rosco-m68k/rosco_keyboard/pics/first-case-proto/IMG_1450.jpg

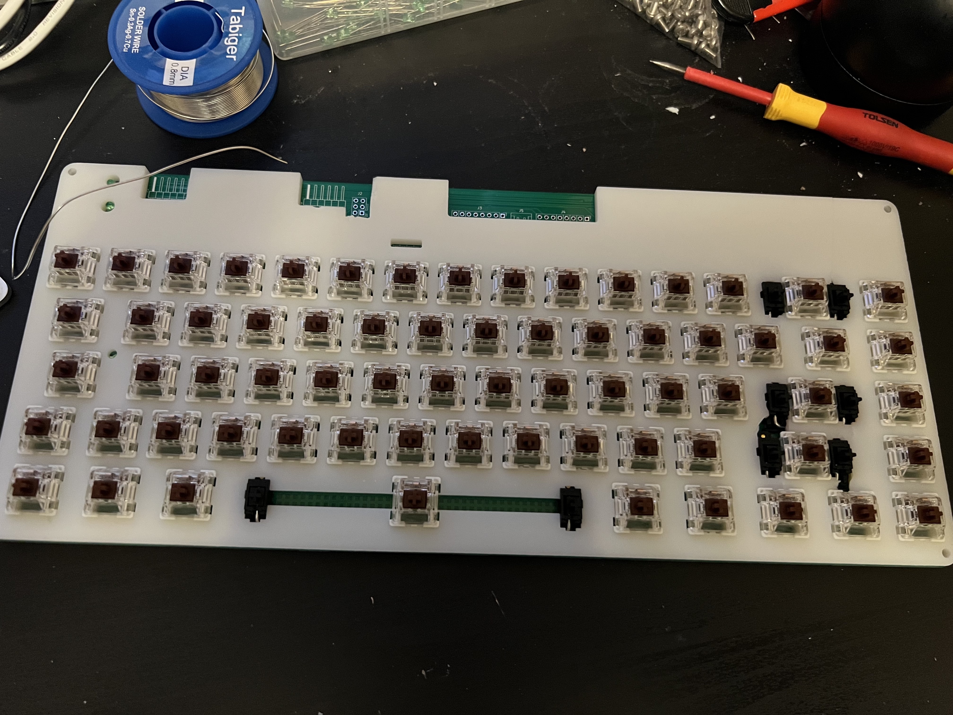
pics/first-case-proto/IMG_1450.jpg
