rosco-m68k/rosco_keyboard/README.md

## rosco_m68k keyboard / case concept

Made non-proprietary and released to open-source with the
licenses outlined in LICENSE.md and LICENSE.hardware, 
under my authority on April 23rd 2025.

_Ross Bamford_

_Managing Director_

_The Really Old-School Company Limited_
