rosco-m68k/rosco_keyboard/keyboard-2-plate v6.png

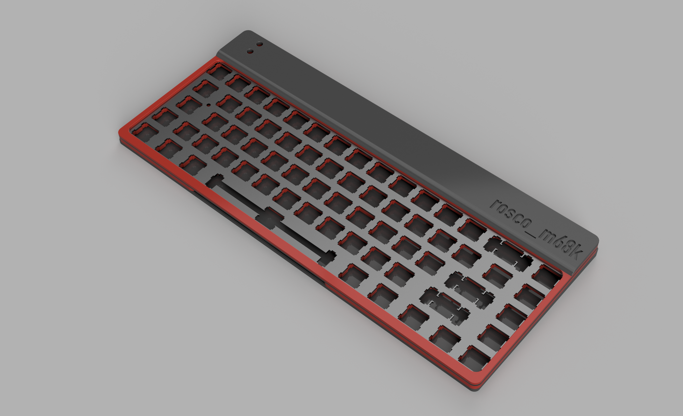
keyboard-2-plate v6.png
