rosco-m68k/rosco_keyboard/pics/first-case-proto/IMG_1453.jpg

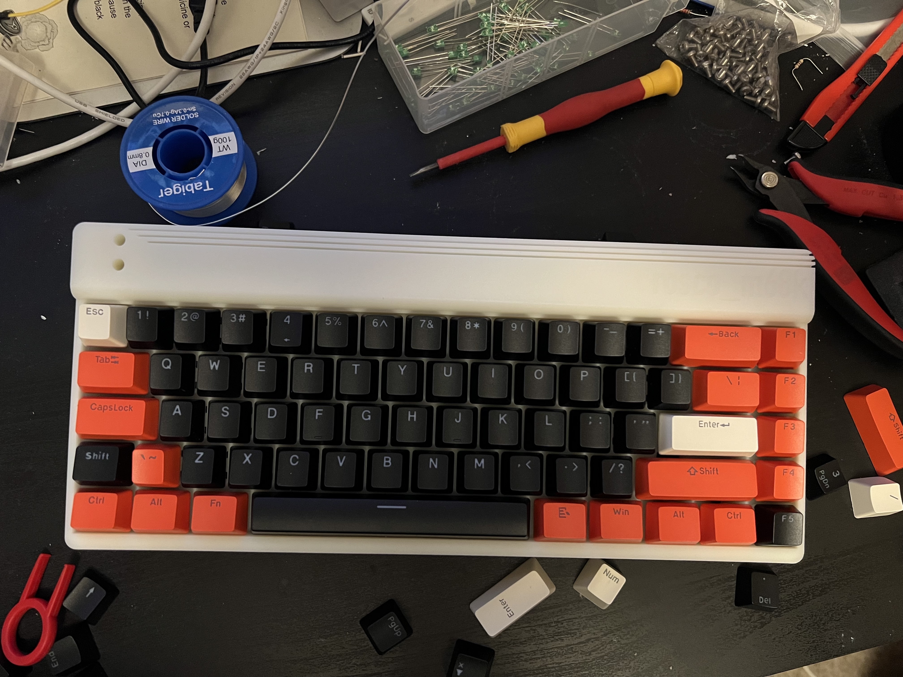
pics/first-case-proto/IMG_1453.jpg
