rosco-m68k/rosco_keyboard/rosco_m68k.png

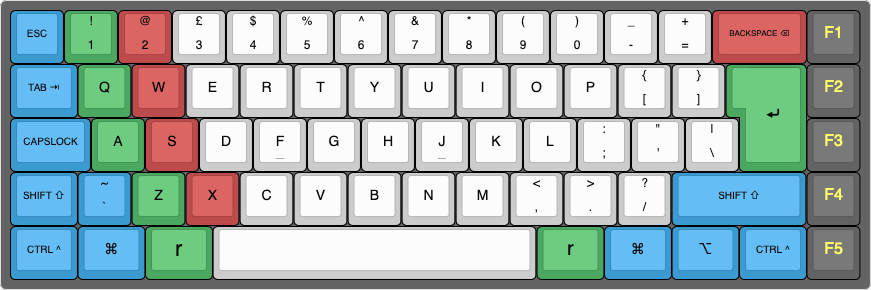
rosco_m68k.png
