rosco-m68k/rosco_keyboard/rosco_m68k_2.png

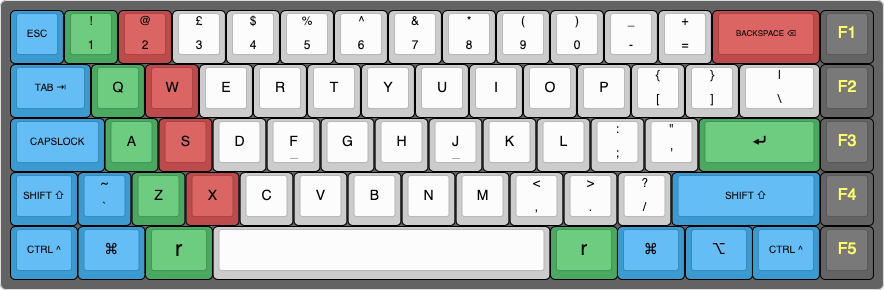
rosco_m68k_2.png
