rosco-m68k/rosco_keyboard/sample-renders/rosco_m68k_mini_case v2 back.png

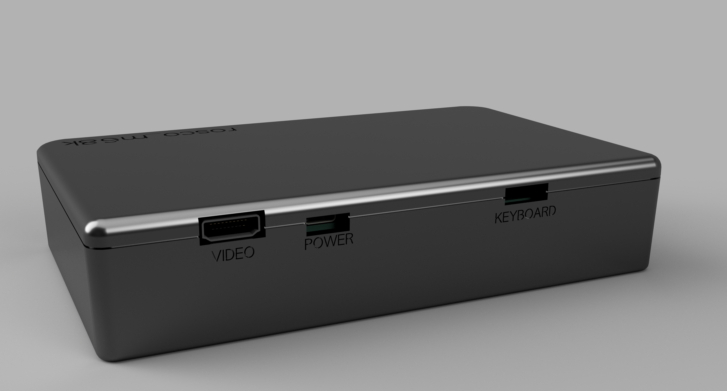
sample-renders/rosco_m68k_mini_case v2 back.png
