rosco-m68k/rosco_keyboard/3d_files/rosco_m68k_keyboard_v24_Base.step

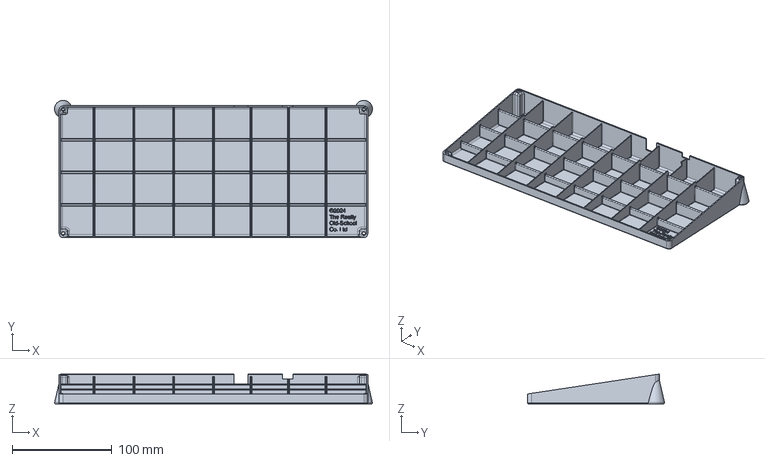
[picture p9: CAD file, 2024-02-29]
3d_files/rosco_m68k_keyboard_v24_Base.step
319.5 x 137.9 x 30.0 mm
