rosco-m68k/rosco_keyboard/3d_files/v27/keyboard-v27-pcb-placeholder.step

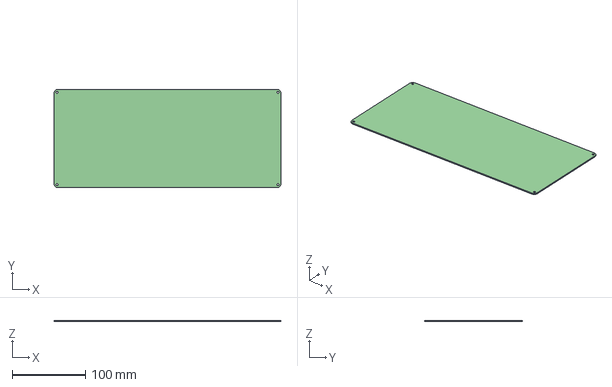
[picture p10: CAD file, 2025-04-23]
3d_files/v27/keyboard-v27-pcb-placeholder.step
310.1 x 134.0 x 1.60 mm
