rosco-m68k/rosco_keyboard/Board Models/rosco_m68k-r2020.STEP

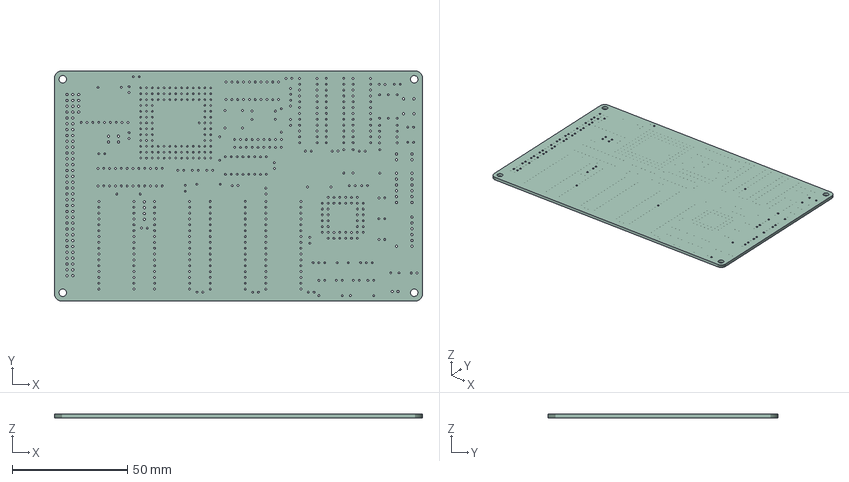
[picture p11: CAD file, 2024-03-07]
Board Models/rosco_m68k-r2020.STEP
160.0 x 100.0 x 1.60 mm
