rosco-m68k/rosco_keyboard/keys-illustration.stl

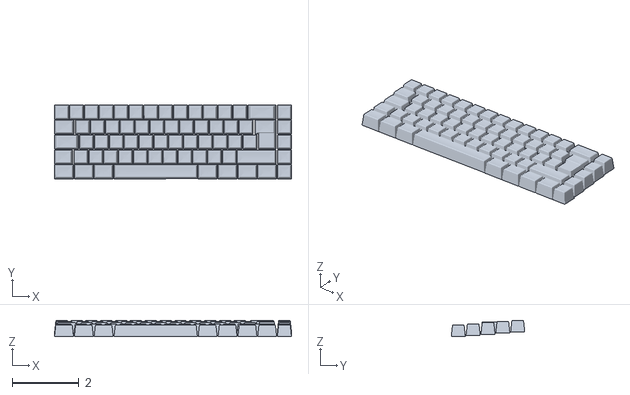
[picture p12: CAD file, 2024-03-07]
keys-illustration.stl
7.13 x 2.21 x 0.487
