rosco-m68k/rosco_keyboard/New Keyb Tests/keyboard-2-plate v25 - Support Holder.step

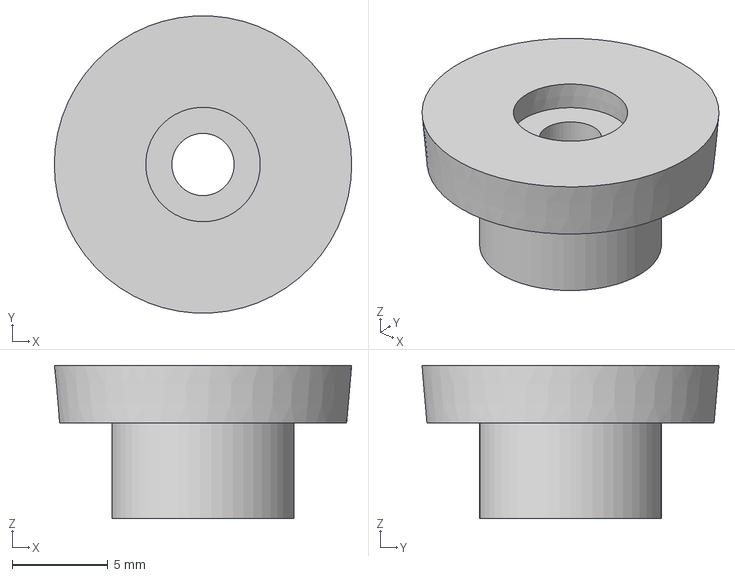
[picture p13: CAD file, 2025-04-23]
New Keyb Tests/keyboard-2-plate v25 - Support Holder.step
15.5 x 15.5 x 8.00 mm
