rosco-m68k/rosco_keyboard/standoffs/Side Standoff.step

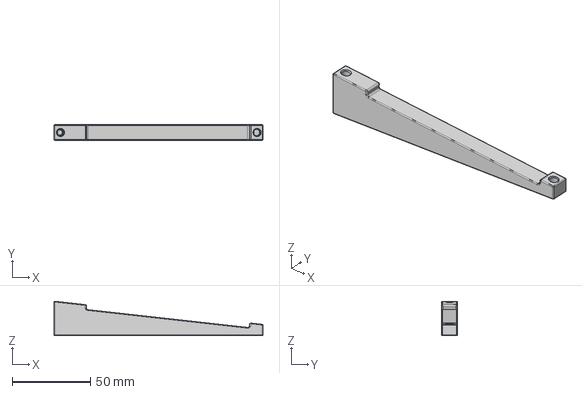
[picture p14: CAD file, 2024-02-17]
standoffs/Side Standoff.step
133.2 x 10.0 x 21.9 mm
