rosco-m68k/rosco_keyboard/3d_files/rosco_m68k_keyboard_v24_Top.step

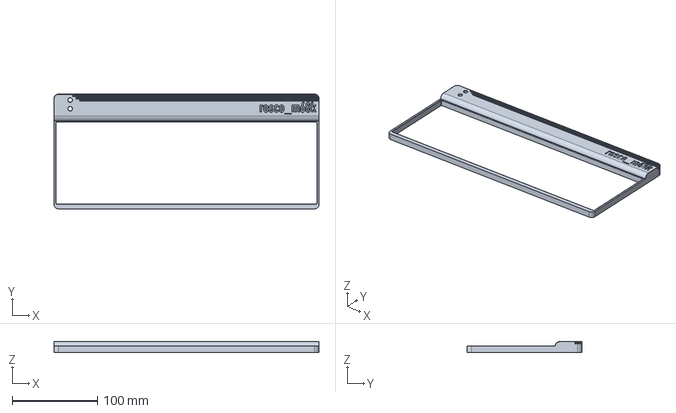
[picture p15: CAD file, 2024-02-29]
3d_files/rosco_m68k_keyboard_v24_Top.step
310.0 x 134.2 x 13.0 mm
