rosco-m68k/rosco_keyboard/New Keyb Tests/keyboard-2-plate v25 - Base LHS.step

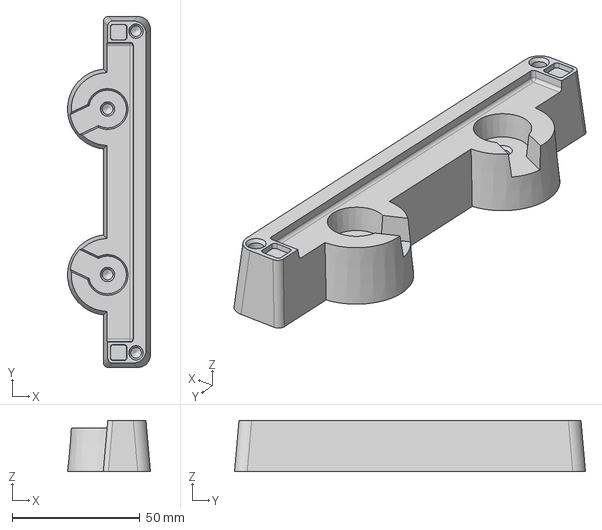
[picture p16: CAD file, 2025-04-23]
New Keyb Tests/keyboard-2-plate v25 - Base LHS.step
32.5 x 137.5 x 20.0 mm
