rosco-m68k/rosco_keyboard/New Keyb Tests/WIP/keyboard-2-plate RHS v2.step

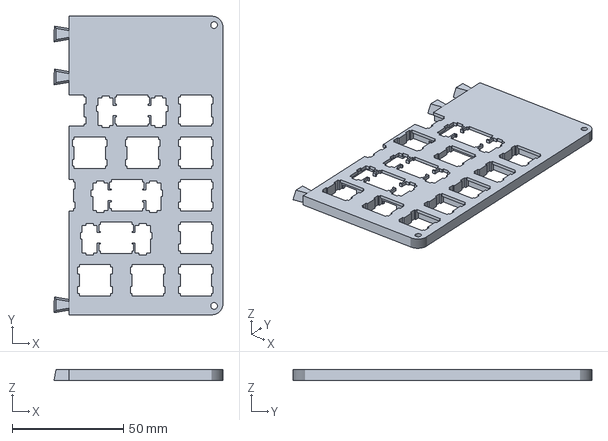
[picture p17: CAD file, 2025-04-23]
New Keyb Tests/WIP/keyboard-2-plate RHS v2.step
75.8 x 134.0 x 5.00 mm
