rosco-m68k/rosco_keyboard/rosco-keyboard-plate-new.dxf

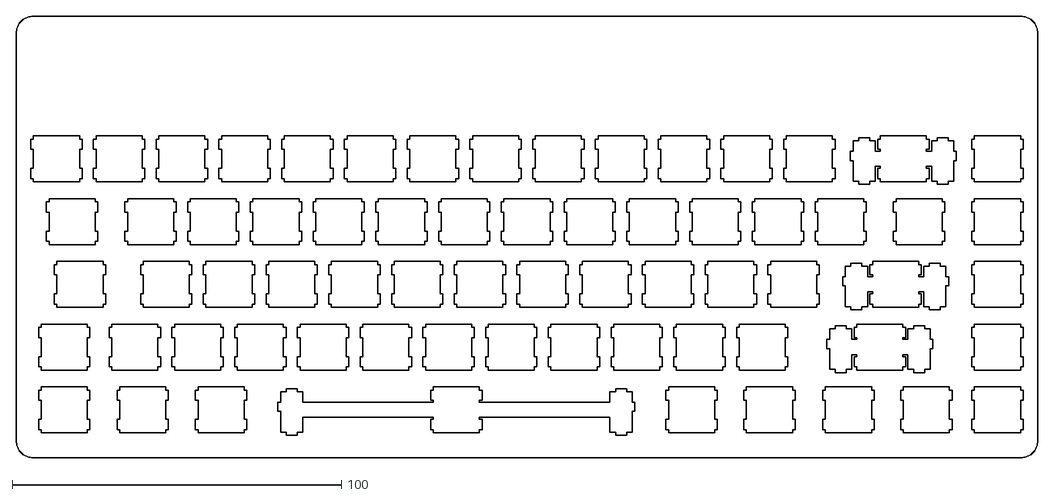
[picture p18: CAD file, 2023-12-27]
rosco-keyboard-plate-new.dxf
310.1 x 134.0
