rosco-m68k/rosco_keyboard/standoffs/keyboard-standoff v9.stl

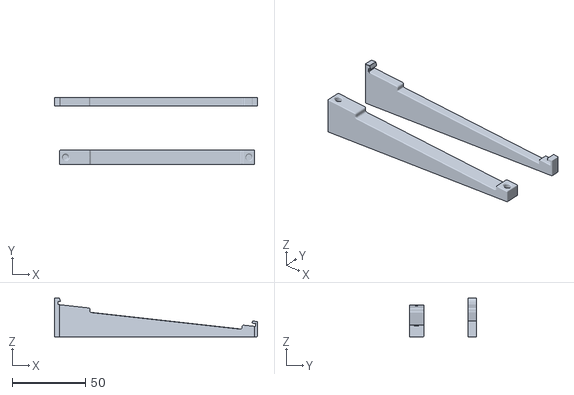
[picture p19: CAD file, 2024-02-17]
standoffs/keyboard-standoff v9.stl
138.6 x 46.0 x 26.5
