rosco-m68k/rosco_keyboard/New Keyb Tests/keyboard-2-plate v24 - Base Middle.step

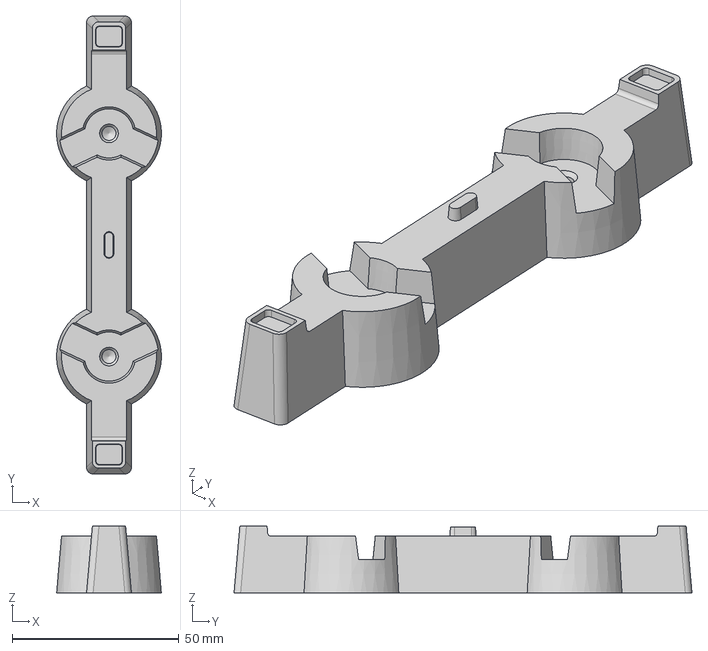
[picture p20: CAD file, 2025-04-23]
New Keyb Tests/keyboard-2-plate v24 - Base Middle.step
31.4 x 137.5 x 20.0 mm
