rosco-m68k/rosco_keyboard/recess-logo-test.stl

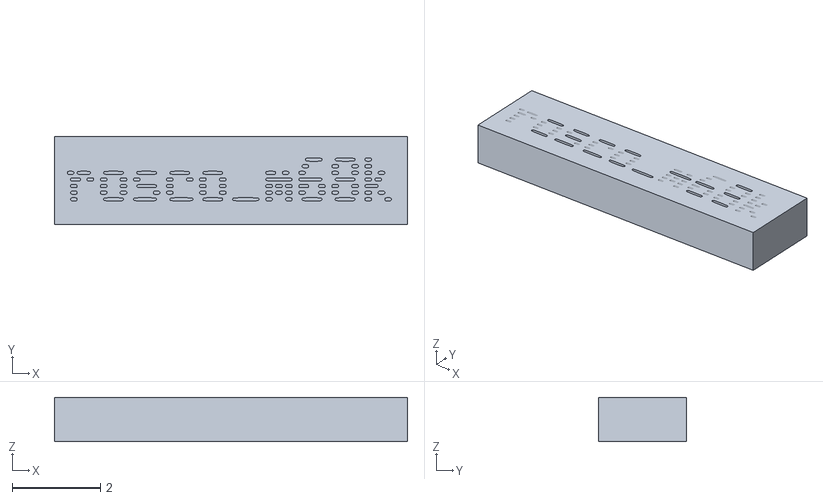
[picture p21: CAD file, 2023-12-16]
recess-logo-test.stl
8.00 x 2.00 x 1.00
