rosco-m68k/rosco_keyboard/New Keyb Tests/keyboard-2-plate v24 - Support X.step

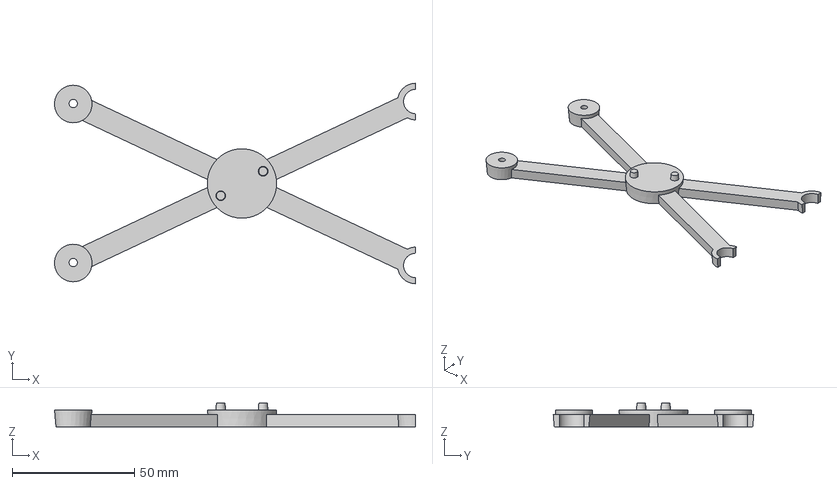
[picture p22: CAD file, 2025-04-23]
New Keyb Tests/keyboard-2-plate v24 - Support X.step
147.6 x 82.0 x 9.75 mm
