rosco-m68k/rosco_keyboard/New Keyb Tests/WIP/keyboard-2-plate v13 - Support Fix.step

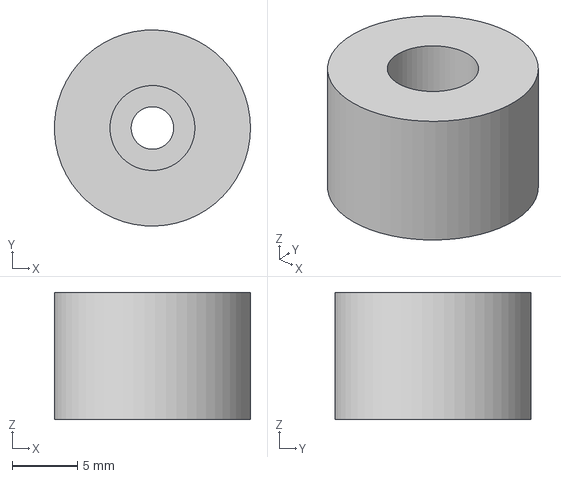
[picture p23: CAD file, 2025-04-23]
New Keyb Tests/WIP/keyboard-2-plate v13 - Support Fix.step
15.0 x 15.0 x 9.75 mm
