rosco-m68k/rosco_keyboard/standoffs/Middle Standoff.step

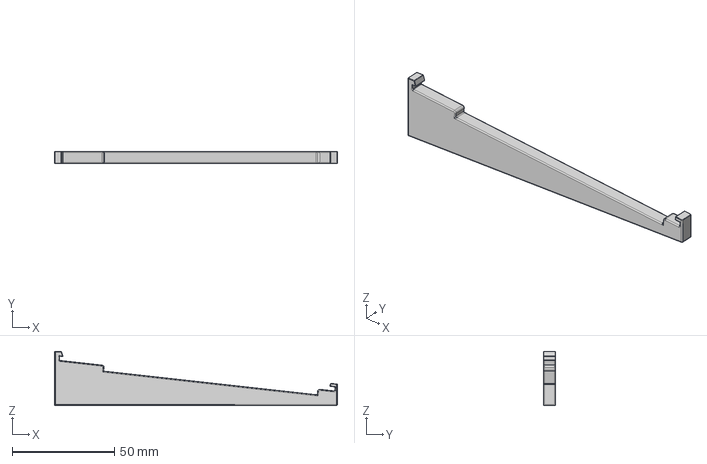
[picture p24: CAD file, 2024-02-15]
standoffs/Middle Standoff.step
138.6 x 6.00 x 26.5 mm
