rosco-m68k/rosco_keyboard/New Keyb Tests/WIP/keyboard-2-plate LHS v1.step

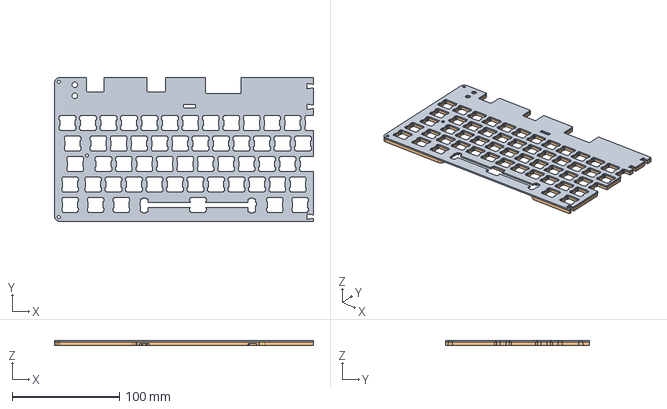
[picture p25: CAD file, 2025-04-23]
New Keyb Tests/WIP/keyboard-2-plate LHS v1.step
241.1 x 134.0 x 5.00 mm
