rosco-m68k/rosco_keyboard/New Keyb Tests/WIP/keyboard-2-plate v15 - Support Fix Top.step

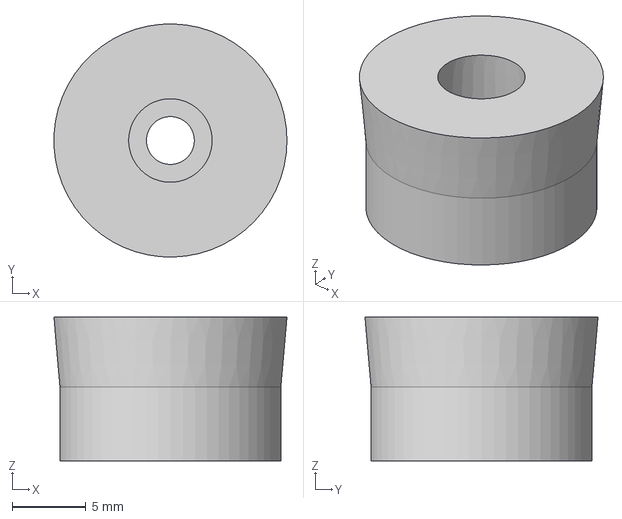
[picture p26: CAD file, 2025-04-23]
New Keyb Tests/WIP/keyboard-2-plate v15 - Support Fix Top.step
15.8 x 15.8 x 9.75 mm
