rosco-m68k/rosco_keyboard/New Keyb Tests/WIP/keyboard-2-plate v18 - Support Top.step

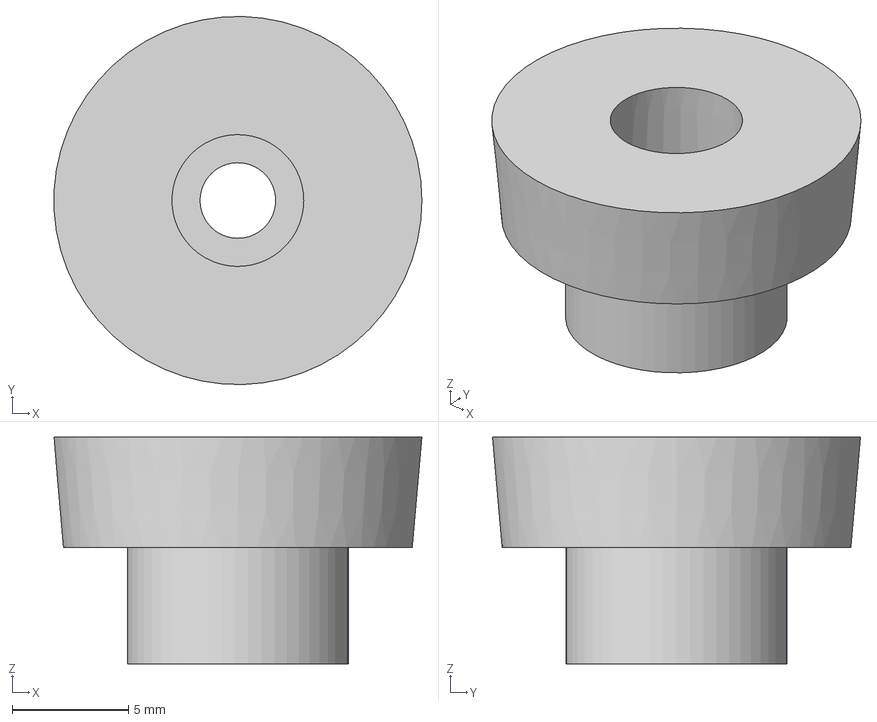
[picture p27: CAD file, 2025-04-23]
New Keyb Tests/WIP/keyboard-2-plate v18 - Support Top.step
15.8 x 15.8 x 9.75 mm
