rosco-m68k/rosco_keyboard/(list of files, cad)

Other CAD files:
3d_files/v27/keyboard-v27-top.step
3d_files/v27/keyboard-v27-base.step
standoffs/keyboard-standoffs v8.stl
New Keyb Tests/keyboard-2-plate v25 - Base RHS.step
New Keyb Tests/WIP/keyboard-2-plate v21 - Support RHS.step
New Keyb Tests/WIP/keyboard-2-plate v24 - Base LHS.step
New Keyb Tests/WIP/keyboard-2-plate v21 - Support LHS.step
New Keyb Tests/WIP/keyboard-2-plate v20 - Base Middle.step
New Keyb Tests/WIP/keyboard-2-plate v24 - Base RHS.step
3d_files/v27/keyboard-v27-PCB-Placeholder.f3d
3d_files/v27/keyboard-v27-base.f3d
3d_files/v27/keyboard-v27-top.f3d
New Keyb Tests/WIP/keyboard-2-plate v10 - Support LHS.step
New Keyb Tests/WIP/keyboard-2-plate v10 - Support RHS.step
New Keyb Tests/WIP/keyboard-2-plate v11 - Base LHS.step
New Keyb Tests/WIP/keyboard-2-plate v11 - Base Middle.step
New Keyb Tests/WIP/keyboard-2-plate v11 - Base RHS.step
New Keyb Tests/WIP/keyboard-2-plate v13 - Base LHS.step
New Keyb Tests/WIP/keyboard-2-plate v13 - Base Middle.step
New Keyb Tests/WIP/keyboard-2-plate v13 - Base RHS.step
New Keyb Tests/WIP/keyboard-2-plate v13 - Support LHS.step
New Keyb Tests/WIP/keyboard-2-plate v13 - Support RHS.step
New Keyb Tests/WIP/keyboard-2-plate v15 - Support LHS.step
New Keyb Tests/WIP/keyboard-2-plate v15 - Support RHS.step
New Keyb Tests/WIP/keyboard-2-plate v18 - Base LHS.step
New Keyb Tests/WIP/keyboard-2-plate v18 - Base Middle.step
New Keyb Tests/WIP/keyboard-2-plate v18 - Base RHS.step
New Keyb Tests/WIP/keyboard-2-plate v20 - Base LHS.step
New Keyb Tests/WIP/keyboard-2-plate v20 - Base RHS.step
New Keyb Tests/WIP/keyboard-2-plate v20 - Support LHS.step
New Keyb Tests/WIP/keyboard-2-plate v20 - Support RHS.step
recess-logo-test.blend
