rosco-m68k/rosco_keyboard/manual-cover.jpg

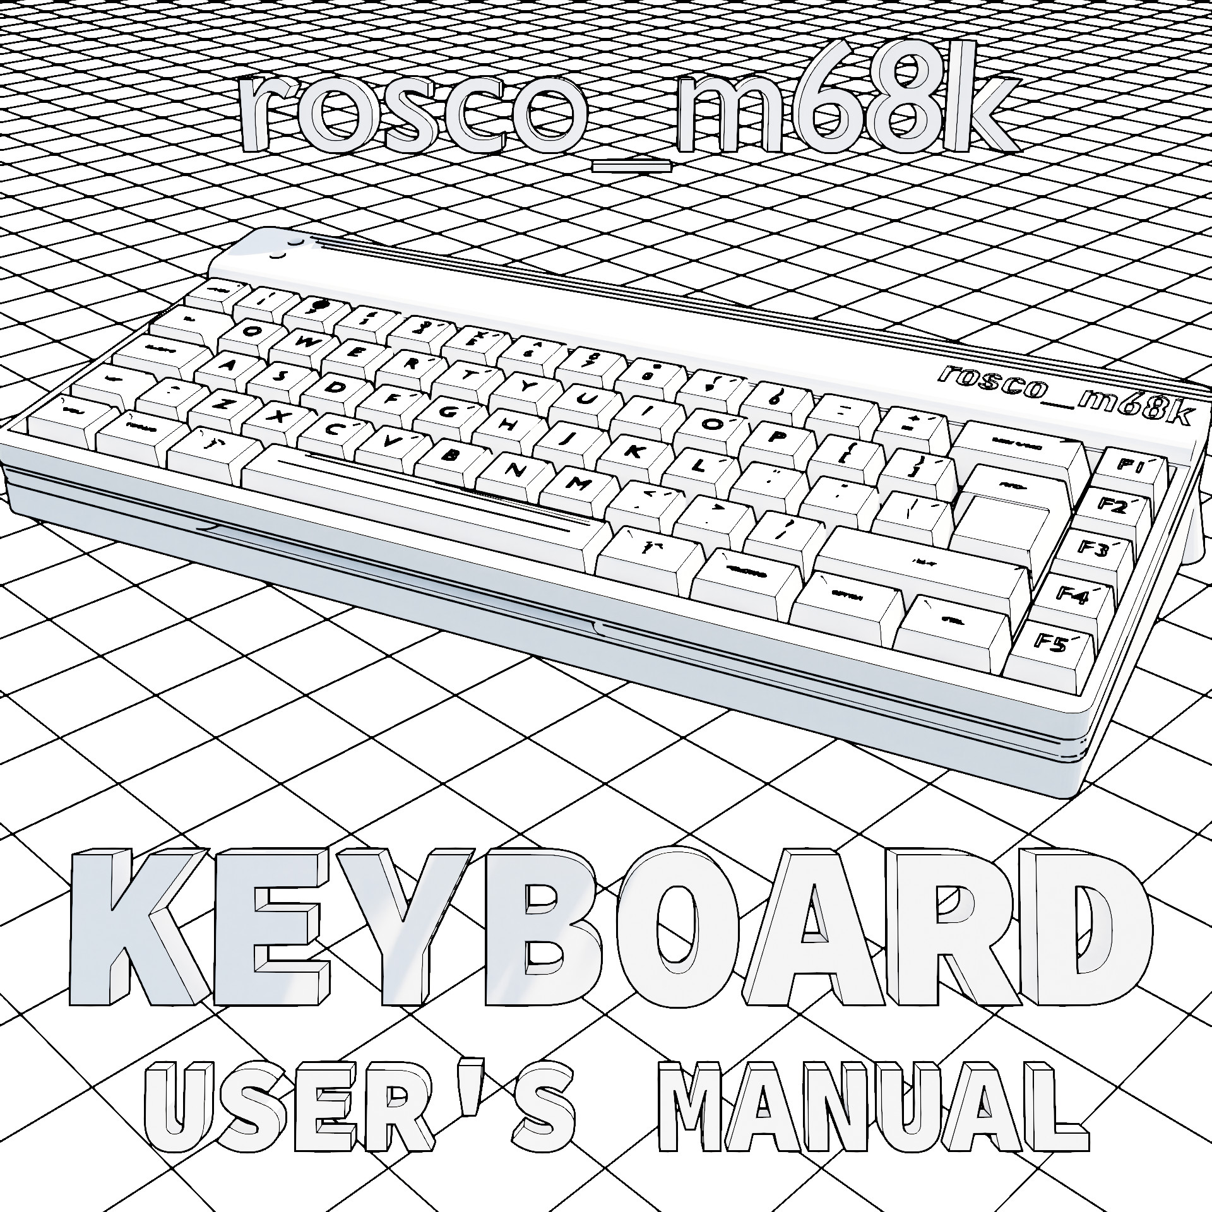
manual-cover.jpg
