rosco-m68k/rosco_keyboard/kicad/rosco_m68k_keyboard-2.pdf

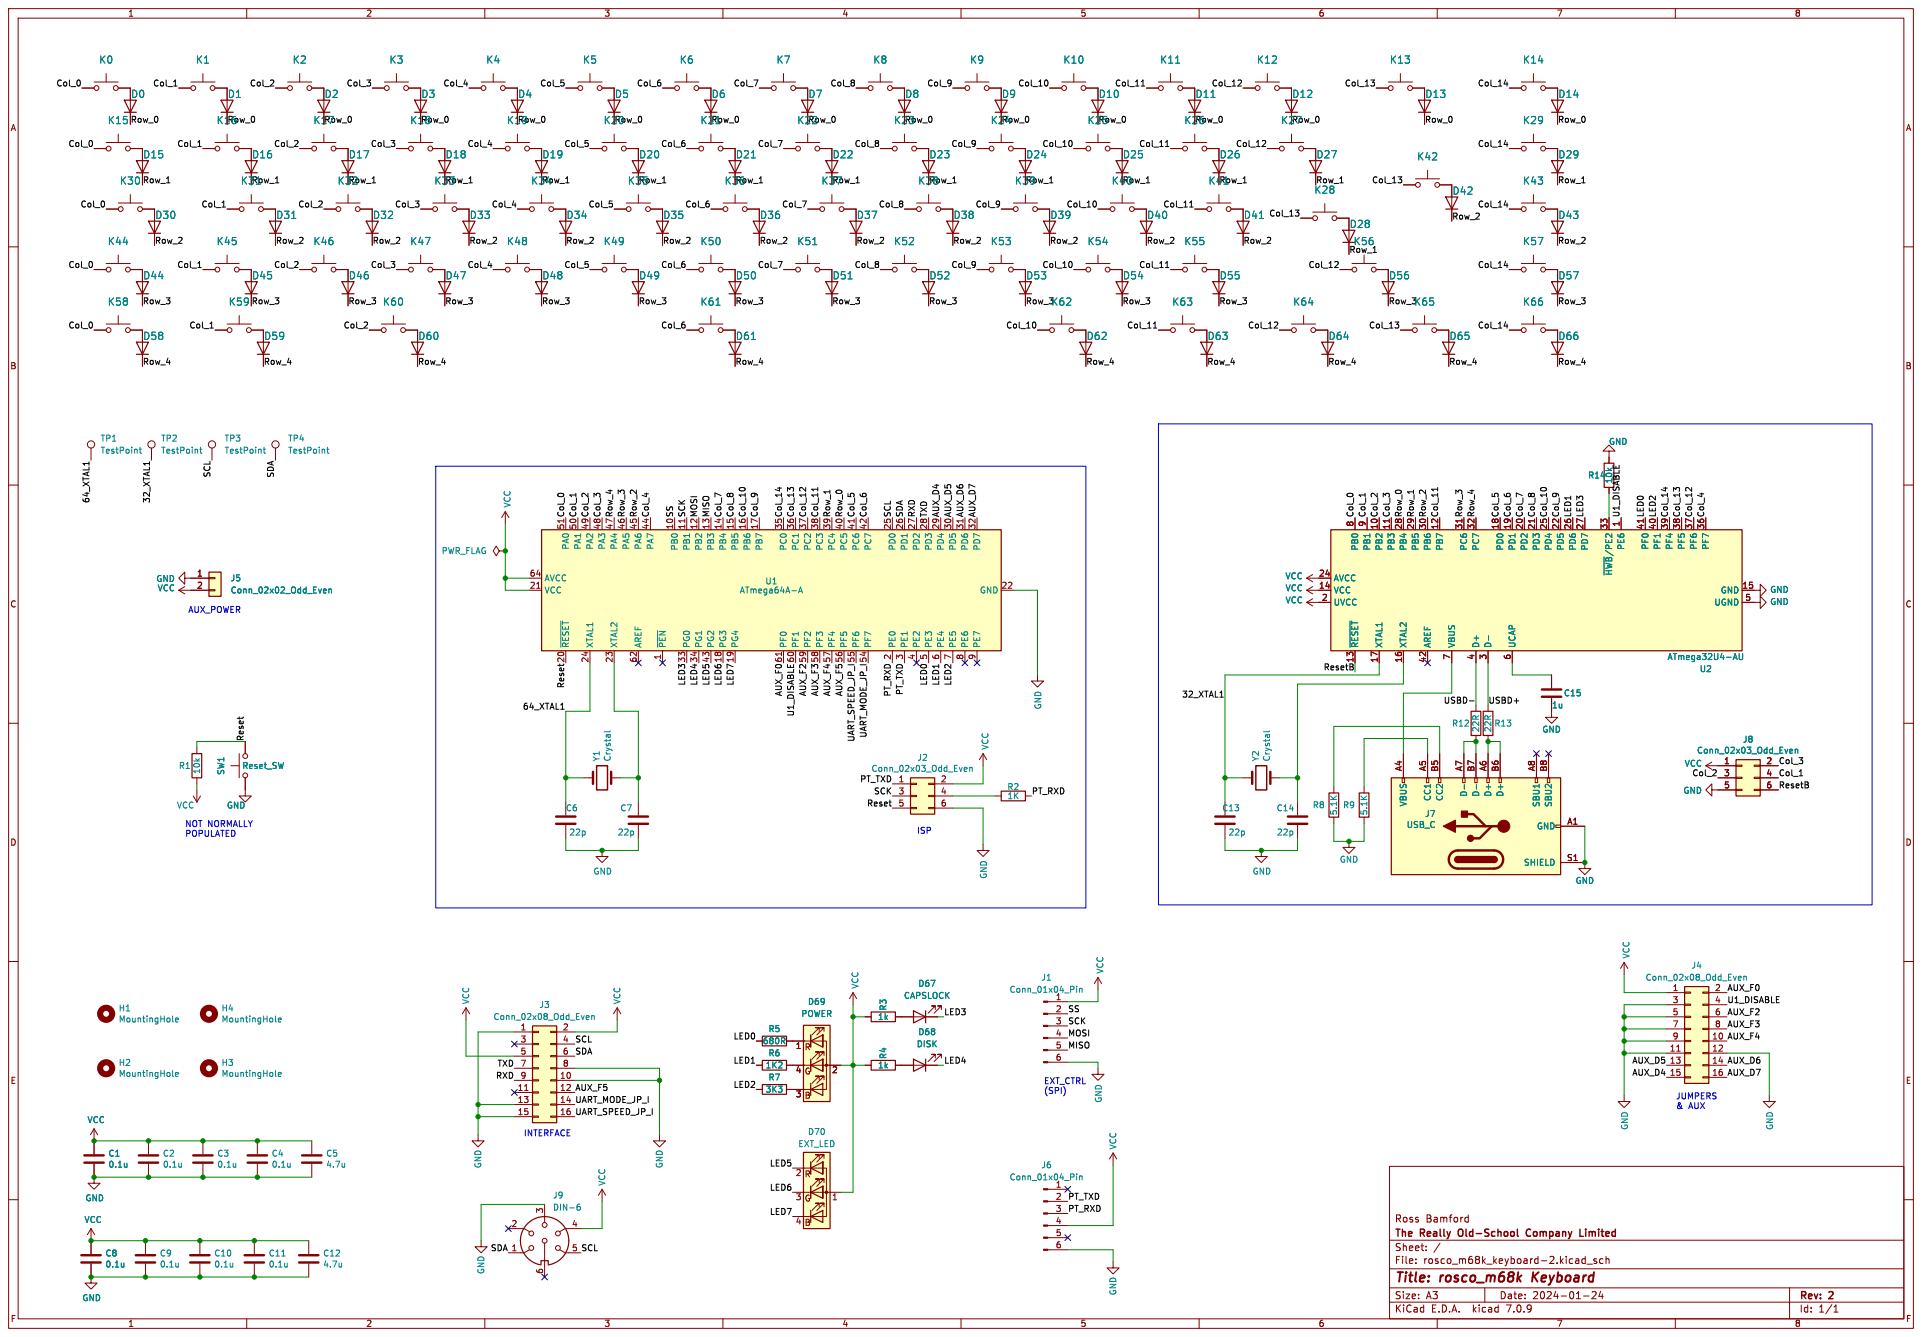
[picture p29: page 1]
