rosco-m68k/rosco_keyboard/(list of files, drawings)

Other design files:
kicad/rosco_m68k_keyboard-2.dsn
