rosco-m68k/rosco_keyboard/code/mcu/src/main.cpp

/*
 * rosco_m68k keyboard microcontroller code
 *
 * Copyright (c)2023-2024 The Really Old-School Company Limited
 *
 * Closed source; Not for distribution.
 * 
 * Scancode format:
 *
 *     Down? | Row                   | Column
 *     ------|-----------------------|--------------------------------
 *     1     | 1     | 1     | 1     | 1     | 1     | 1     | 1
 *     ------|-----------------------|--------------------------------
 *     128   |  64   | 32    | 16    | 8     | 4     | 2     | 1
 * 
 * Row and column are 1-based in this scheme.
 * 
 * Rows six and seven represent special things:
 *
 *      PS/2 Mouse - Packets always start with an "up" code for row 6, col 0
 *                   Four bytes follow (containing an Intellimouse PS/2 packet)
 *
 *      SPI        - Each byte received via the SPI interface will result in two scancode
 *                   bytes, both identified as UP, column 7, with the low nibble containing
 *                   half of the received byte, e.g. 0b0111nnnn (REVISION 2 ONLY).
 */

#define REVISION_2

#include "config.hpp"

#include <Arduino.h>
#ifdef REVISION_2
#include <SPI.h>
#endif
#include <PS2MouseHandler.h>
#include <avr/wdt.h>

#include "command.hpp"
#include "pins.hpp"
#include "tables.hpp"

// On mega64 we're using UART 1 as the main
#define M_UART              Serial1
// ... and UART 0 as the passthru
#define PT_UART             Serial

static bool keys[ROW_COUNT][COL_COUNT];
static unsigned long keys_t[ROW_COUNT][COL_COUNT];
static bool keys_r[ROW_COUNT][COL_COUNT];

static uint8_t current_command;

static uint16_t repeat_delay;
static uint8_t repeat_rate_limit;

static bool global_disable;
static bool i2c_mode;
static bool uart_mode;
static bool uart_passthru;
static bool uart_caps;
static bool uart_caps_word;
static bool uart_caps_led_on;
static long uart_caps_word_flash_last;
static bool uart_lshift;
static bool uart_rshift;
static bool uart_lctrl;
static bool uart_rctrl;
static bool uart_lcmd;
static bool uart_rcmd;
static bool uart_option;
static bool uart_lrosco;
static bool uart_rrosco;

static PS2MouseHandler mouse(PS2_CLOCK, PS2_DATA, PS2_MOUSE_REMOTE);
static bool have_mouse;
static bool enable_mouse_reports;
static struct {
    int x, y, z;
    uint8_t s;
} mouse_last;

#ifdef REVISION_2
static uint8_t spi_buf[SPI_BUF_SIZE];
volatile static uint16_t spi_ptr_r;
volatile static uint16_t spi_ptr_w;
static bool enable_spi_reports;
#endif

static inline __attribute__((always_inline)) uint8_t keyup(int row, int col) {
    return (row + 1) << 4 | (col + 1);
}

static inline __attribute__((always_inline)) uint8_t keydown(int row, int col) {
    return 0x80 | keyup(row, col);
}

/* ** LEDs on LED Port ** */
static inline __attribute__((always_inline)) void led_off(const uint8_t led_mask) {
    LED_OPORT |= led_mask;
}

static inline __attribute__((always_inline)) void led_on(const uint8_t led_mask) {
    LED_OPORT &= ~(led_mask);
}

static inline __attribute__((always_inline)) void led_set(const uint8_t led_mask, uint8_t brightness) {
    if (brightness) {
        led_on(led_mask);
    } else {
        led_off(led_mask);
    }
}

/* ** LEDs on POW Port ** */
static inline __attribute__((always_inline)) void pow_off(const uint8_t led_mask) {
    POW_OPORT |= led_mask;
}

static inline __attribute__((always_inline)) void pow_on(const uint8_t led_mask) {
    POW_OPORT &= ~(led_mask);
}

static inline __attribute__((always_inline)) void pow_set(const uint8_t led_mask, uint8_t brightness) {
    if (brightness) {
        pow_on(led_mask);
    } else {
        pow_off(led_mask);
    }
}

#ifdef REVISION_2
/*
 * SPI ISR
 */
ISR(SPI_STC_vect) {
    unsigned char c = SPDR;

    spi_buf[spi_ptr_w++] = c;
    spi_ptr_w &= SPI_BUF_MASK;
}

static inline __attribute__((always_inline)) void service_spi(void) {
    // Only sending one byte per call rather than emptying the buffer.
    // Since this is called in the matrix scan loop, this means we 
    // will keep servicing SPI without letting it overrun the whole 
    // system...
    //
    // We don't need to disable interrupts because of the circular buffer,
    // it's possible (but unlikely) we can miss data if the buffer overruns - 
    // disabling interrupts wouldn't help - we'd just miss it altogether
    // in that case which isn't any better (I'd actually argue worse since 
    // probably more likely...)
    //
    if (!uart_mode && enable_spi_reports && spi_ptr_r != spi_ptr_w) {
        unsigned char c = spi_buf[spi_ptr_r++];
        spi_ptr_r &= SPI_BUF_MASK;
        M_UART.write(0x7 | (c & 0xF0) >> 4);
        M_UART.write(0x7 | (c & 0x0F));
    }
}
#else
static inline __attribute__((always_inline)) void service_spi(void) {
}
#endif

static inline __attribute__((always_inline)) bool service_mouse(void) {
    if (!mouse.get_data()) {
        // Fail fast and disable mouse reporting if we timed out,
        // to avoid degrading keyboard experience...
        //
        // Software can try to re-enable if it likes...
        enable_mouse_reports = false;
        have_mouse = false;
        return false;
    }

    uint8_t s = mouse.status();
    int x = mouse.x_movement();
    int y = mouse.y_movement();
    int z = mouse.z_movement();

    if (x != mouse_last.x || y != mouse_last.y || z != mouse_last.z || s != mouse_last.s) {
        // send report
        M_UART.write(PS2_PKT_START_CODE);
        M_UART.write(s);
        M_UART.write((uint8_t)abs(x));      // Sign/overflow represented in status....
        M_UART.write((uint8_t)abs(y));
        M_UART.write((uint8_t)abs(z));

        mouse_last.x = x;
        mouse_last.y = y;
        mouse_last.z = z;
        mouse_last.s = s;
    }

    return true;
}

static void process_command(int byte) {
    if (byte < 0) {
        return;
    }

    if (current_command == 0) {
        switch (byte) {
        // starting a command
        case CMD_LED_POWRED:
        case CMD_LED_POWGRN:
        case CMD_LED_POWBLU:
        case CMD_LED_CAPS:
        case CMD_LED_DISK:
        case CMD_LED_EXTRED:
        case CMD_LED_EXTGRN:
        case CMD_LED_EXTBLU:
        case CMD_MODE_SET:
        case CMD_RPT_DELAY_SET:
        case CMD_RPT_RATE_SET:
        case CMD_MOUSE_SET_RATE:
        case CMD_MOUSE_SET_RES:
        case CMD_MOUSE_SET_SCALE:
            current_command = byte;
            M_UART.write(CMD_ACK);
            break;
        case CMD_MOUSE_DETECT:
            if (!i2c_mode) {
                if (mouse.initialise() == 0) {  // 0 == ok, else timeout
                    have_mouse = true;
                    M_UART.write(CMD_ACK);
                } else {
                    M_UART.write(CMD_NAK);
                }
            } else {
                M_UART.write(CMD_NAK);
            }
            break;
        case CMD_MOUSE_STRM_ON:
            if (!i2c_mode && !uart_mode) {
                if (mouse.initialise() == 0) {  // 0 == ok, else timeout
                    have_mouse = true;
                    enable_mouse_reports = true;
                    M_UART.write(CMD_ACK);
                } else {
                    // In case we're reinitializing after unplug and haven't noticed yet...
                    have_mouse = false;
                    enable_mouse_reports = false;
                    M_UART.write(CMD_NAK);
                }
            } else {
                M_UART.write(CMD_NAK);
            }
            break;
        case CMD_MOUSE_STRM_OFF:
            enable_mouse_reports = false;
            M_UART.write(CMD_ACK);
            break;
        case CMD_MOUSE_REPORT:
            if (i2c_mode) {
                M_UART.write(CMD_NAK);
            } else {
                if (!have_mouse) {
                    if (mouse.initialise() != 0) {  // 0 == ok, else timeout
                        M_UART.write(CMD_NAK);
                        break;
                    }

                    have_mouse = true;
                }

                if (service_mouse()) {
                    M_UART.write(CMD_ACK);
                } else {
                    M_UART.write(CMD_NAK);
                }
            }

            break;
#ifdef REVISION_2
        case CMD_SPI_ENABLE:
            if (uart_mode) {
                M_UART.write(CMD_NAK);
            } else {
                enable_spi_reports = true;
                M_UART.write(CMD_ACK);
            }
            break;
        case CMD_SPI_DISABLE:
            enable_spi_reports = false;
            M_UART.write(CMD_ACK);
            break;
#endif
        case CMD_RESET:
            M_UART.write(CMD_ACK);
            wdt_enable(WDTO_15MS);
            while (1);
        case CMD_IDENT:
            M_UART.write("rosco_kbd");
            if (uart_mode) {
                M_UART.write(IDENT_MODE_ASCII);
            } else {
                M_UART.write(IDENT_MODE_SCAN);
            }
            M_UART.write(KEY_COUNT);
            M_UART.write(LED_COUNT);

            if (i2c_mode) {
                M_UART.write(CAPABILITIES | CAP_I2C);
            } else {
                M_UART.write(CAPABILITIES | CAP_PS2);
            }

            M_UART.write((uint8_t)0);
            M_UART.write((uint8_t)0);
            M_UART.write(CMD_ACK);
            break;
        default:
            M_UART.write(CMD_NAK);
        }
    } else {
        // operand
        switch (current_command) {
        case CMD_LED_POWRED:
            pow_set(POW_RED, byte);
            M_UART.write(CMD_ACK);
            current_command = 0;
            break;
        case CMD_LED_POWGRN:
            pow_set(POW_GRN, byte);
            M_UART.write(CMD_ACK);
            current_command = 0;
            break;
        case CMD_LED_POWBLU:
            pow_set(POW_BLU, byte);
            M_UART.write(CMD_ACK);
            current_command = 0;
            break;
        case CMD_LED_CAPS:
            led_set(LED_CAPS, byte);
            uart_caps_led_on = byte > 0;
            M_UART.write(CMD_ACK);
            current_command = 0;
            break;
        case CMD_LED_DISK:
            led_set(LED_DISK, byte);
            M_UART.write(CMD_ACK);
            current_command = 0;
            break;
        case CMD_LED_EXTRED:
            led_set(LED_EXTRED, byte);
            M_UART.write(CMD_ACK);
            current_command = 0;
            break;
        case CMD_LED_EXTGRN:
            led_set(LED_EXTGRN, byte);
            M_UART.write(CMD_ACK);
            current_command = 0;
            break;
        case CMD_LED_EXTBLU:
            led_set(LED_EXTBLU, byte);
            M_UART.write(CMD_ACK);
            current_command = 0;
            break;
        case CMD_MODE_SET:
            if (byte == CMD_MODE_SCAN) {
                uart_mode = false;
                M_UART.write(CMD_ACK);
            } else if (byte == CMD_MODE_ASCII) {
                uart_mode = true;
                enable_mouse_reports = false;
                M_UART.write(CMD_ACK);
            } else {
                M_UART.write(CMD_NAK);
            }
            current_command = 0;
            break;
        case CMD_RPT_DELAY_SET:
            repeat_delay = byte * 10;
            M_UART.write(CMD_ACK);
            current_command = 0;
            break;
        case CMD_RPT_RATE_SET:
            if (byte == 0) {
                M_UART.write(CMD_NAK);
            } else {
                repeat_rate_limit = (uint8_t)(256 - byte);
                M_UART.write(CMD_ACK);
            }
            current_command = 0;
            break;            
        case CMD_MOUSE_SET_RATE:
            if (have_mouse) {
                switch (byte) {
                case 10:
                case 20:
                case 40:
                case 60:
                case 80:
                case 100:
                case 200:
                    mouse.set_sample_rate(byte, false);
                    M_UART.write(CMD_ACK);
                    break;
                default:
                    M_UART.write(CMD_NAK);
                }
            } else {
                M_UART.write(CMD_NAK);
            }
            current_command = 0;
            break;
        case CMD_MOUSE_SET_RES:
            if (have_mouse) {
                if (byte >= 0 && byte < 5) {
                    mouse.set_resolution(byte);
                    M_UART.write(CMD_ACK);
                } else {
                    M_UART.write(CMD_NAK);
                }
            } else {
                M_UART.write(CMD_NAK);
            }
            current_command = 0;
            break;
        case CMD_MOUSE_SET_SCALE:
            if (have_mouse) {
                switch (byte) {
                case CMD_MOUSE_SCL_11:
                    mouse.set_scaling_1_1();
                    M_UART.write(CMD_ACK);
                    break;
                case CMD_MOUSE_SCL_21:
                    mouse.set_scaling_2_1();
                    M_UART.write(CMD_ACK);
                    break;
                default:
                    M_UART.write(CMD_NAK);
                }
            } else {
                M_UART.write(CMD_NAK);
            }
            current_command = 0;
            break;
        default:
            M_UART.write(CMD_NAK);
            current_command = 0;
        }
    }
}

static inline __attribute__((always_inline)) bool key_is_repeatable(uint8_t key) {
    switch (key) {
    case CAPS_CODE_U:
    case CAPS_CODE_D:
    case SHIFT_LEFT_CODE_D:
    case SHIFT_LEFT_CODE_U:
    case SHIFT_RIGHT_CODE_D:
    case SHIFT_RIGHT_CODE_U:
    case CTRL_LEFT_CODE_D:
    case CTRL_LEFT_CODE_U:
    case CTRL_RIGHT_CODE_D:
    case CTRL_RIGHT_CODE_U:
    case CMD_LEFT_CODE_D:
    case CMD_LEFT_CODE_U:
    case CMD_RIGHT_CODE_D:
    case CMD_RIGHT_CODE_U:
    case ROSCO_LEFT_CODE_D:
    case ROSCO_LEFT_CODE_U:
    case ROSCO_RIGHT_CODE_D:
    case ROSCO_RIGHT_CODE_U:
    case OPTION_CODE_D:
    case OPTION_CODE_U:
        return false;
    }

    return true;
}

static inline __attribute__((always_inline)) bool is_ascii_word_terminator(uint8_t ascii) {
    // A word about the logic for choosing these... 
    //
    // Most of the choices here are obvious. However, there are a few that maybe aren't:
    //
    // Double-quotes aren't considered word endings. If they _do_ end a word, they'll 
    // usually be followed by a space or some other word-ending anyhow. And I expect it's
    // common to start caps-word mode _before_ you type the _opening_ quote, which would
    // then immediately get cancelled. Backticks follow the same logic (as do single-quotes,
    // but they're already apostophes anyway so wouldn't have been word endings).
    //
    // Same deal for the opening brackets (though in those cases, we _do_ have separate
    // open/close characters, so we can differentiate - this is inconsistent, but I think
    // will probably be "least surprising"...)
    //
    // - and _ aren't word endings either, both because I'm a programmer, and because
    // they aren't word endings IRL either...
    //
    switch (ascii) {
    case ' ':
    case '\n':
    case '\r':
    case '\t':
    case '!':
    case '@':
    case '#':
    case '$':
    case '%':
    case '^':
    case '&':
    case '*':
    case ')':
    case '=':
    case '+':
    case ']':
    case '}':
    case ';':
    case ':':
    case '\\':
    case '|':
    case ',':
    case '<':
    case '.':
    case '>':
    case '/':
    case '?':
        return true;
    }

    return false;
}

static inline __attribute__((always_inline)) bool uart_process_special(uint8_t key) {
    switch (key) {
    case CAPS_CODE_U:
        if (uart_caps_word) {
            // always turn caps word into lock
            uart_caps_word = false;
            uart_caps = true;
            led_set(LED_CAPS, 255);
            uart_caps_led_on = true;
        } else {
            if ((uart_caps = !uart_caps)) {
                led_set(LED_CAPS, 255);
                uart_caps_led_on = true;
            } else {
                led_set(LED_CAPS, 0);
                uart_caps_led_on = false;
            }
        }

        return true;
    case SHIFT_LEFT_CODE_D:
        uart_lshift = true;
        return true;
    case SHIFT_LEFT_CODE_U:
        uart_lshift = false;
        return true;
    case SHIFT_RIGHT_CODE_D:
        uart_rshift = true;
        return true;
    case SHIFT_RIGHT_CODE_U:
        uart_rshift = false;
        return true;
    case CTRL_LEFT_CODE_D:
        uart_lctrl = true;
        return true;
    case CTRL_LEFT_CODE_U:
        uart_lctrl = false;
        return true;
    case CTRL_RIGHT_CODE_D:
        uart_rctrl = true;
        return true;
    case CTRL_RIGHT_CODE_U:
        uart_rctrl = false;
        return true;
    case CMD_LEFT_CODE_D:
        uart_lcmd = true;
        return true;
    case CMD_LEFT_CODE_U:
        uart_lcmd = false;
        return true;
    case CMD_RIGHT_CODE_D:
        uart_rcmd = true;
        return true;
    case CMD_RIGHT_CODE_U:
        uart_rcmd = false;
        return true;
    case ROSCO_LEFT_CODE_D:
        uart_lrosco = true;
        return true;
    case ROSCO_LEFT_CODE_U:
        uart_lrosco = false;
        return true;
    case ROSCO_RIGHT_CODE_D:
        uart_rrosco = true;
        return true;
    case ROSCO_RIGHT_CODE_U:
        uart_rrosco = false;
        return true;
    case OPTION_CODE_D:
        uart_option = true;
        return true;
    case OPTION_CODE_U:
        uart_option = false;
        return true;
    }

    return false;
}

static inline __attribute__((always_inline)) uint8_t uart_keybreak_code(uint8_t code) {
    if (uart_lctrl || uart_rctrl) {
        return pgm_read_byte_near(uart_keys_control + code);
    } else if (uart_option) {
        return pgm_read_byte_near(uart_keys_option_unshift_1 + code);
    } else if (uart_caps || uart_caps_word) {
        if (uart_lshift || uart_rshift) {
            return pgm_read_byte_near(uart_keys_caps_shift + code);
        } else {
            return pgm_read_byte_near(uart_keys_caps_unshift + code);
        }
    } else {
        if (uart_lshift || uart_rshift) {
            return pgm_read_byte_near(uart_keys_nocaps_shift + code);
        } else {
            return pgm_read_byte_near(uart_keys_nocaps_unshift + code);
        }
    }

    return 0;
}

/*
 * This just handles second byte for UTF-8 (Option+<key>), returns 0
 * when not applicable...
 */
static inline __attribute__((always_inline)) uint8_t uart_keybreak_code_2(uint8_t code) {
    if (uart_option) {
        return pgm_read_byte_near(uart_keys_option_unshift_2 + code);
    }

    return 0;
}

/*
 * This just handles third byte for UTF-8 (Option+<key>), returns 0
 * when not applicable...
 */
static inline __attribute__((always_inline)) uint8_t uart_keybreak_code_3(uint8_t code) {
    if (uart_option) {
        return pgm_read_byte_near(uart_keys_option_unshift_3 + code);
    }

    return 0;
}

static inline __attribute__((always_inline)) void uart_send_keypress(uint8_t code) {
    uint8_t ascii = uart_keybreak_code(code);
    uint8_t ascii2 = uart_keybreak_code_2(code);
    uint8_t ascii3 = uart_keybreak_code_3(code);

    if (ascii > 0) {
        M_UART.write(ascii);
    }
    if (ascii2 > 0) {
        M_UART.write(ascii2);
    }
    if (ascii3 > 0) {
        M_UART.write(ascii3);
    }
}

static inline __attribute__((always_inline)) void uart_repeat_keypress(int row, int col) {
    uint8_t code = keyup(row, col);

    if (key_is_repeatable(code)) {
        uart_send_keypress(code);
    }
}

// MY GOD THIS NEEDS BREAKING UP AND REFACTORING!! 😧 
//        - @roscopeco 2024-01-14
//
static inline __attribute__((always_inline)) void uart_loop(void) {
    unsigned long now = millis();

    for (int row = 0; row < ROW_COUNT; row++) {
        uint8_t row_pin = pgm_read_byte_near(row_pins + row);
        pinMode(row_pin, OUTPUT);
        digitalWrite(row_pin, LOW);

#       if ROW_SETTLE_DELAY
        delayMicroseconds(ROW_SETTLE_DELAY);
#       endif

        for (int col = 0; col < COL_COUNT; col++) {
            // Handle any passthru...
            if (uart_passthru) {
                while (PT_UART.available() > 0) {
                    M_UART.write(PT_UART.read());
                }
                while (M_UART.available() > 0) {
                    PT_UART.write(M_UART.read());
                }
            }

            uint8_t col_pin = pgm_read_byte_near(col_pins + col);

            if (now - keys_t[row][col] > DEBOUNCE_MILLIS) {
                if (!digitalRead(col_pin)) {
                    if (!keys[row][col]) {
                        keys[row][col] = true;
                        keys_t[row][col] = now;

                        uint8_t code = keydown(row, col);
                        if (uart_process_special(code)) {
                            // Special handling for caps-word
                            if (code == SHIFT_LEFT_CODE_D) {
                                if (uart_rshift) {
                                    if (uart_caps_word) {
                                        // cancel caps word
                                        uart_caps_word = false;
                                        uart_caps = false;
                                        uart_caps_led_on = false;
                                        led_off(LED_CAPS);
                                    } else {
                                        // enable caps word
                                        if (uart_caps_led_on) { // Immediate flash start!
                                            led_off(LED_CAPS);  // start off if already on
                                            uart_caps_led_on = false;
                                        } else {
                                            led_on(LED_CAPS);   // and vice versa
                                            uart_caps_led_on = true;
                                        }

                                        uart_caps_word = true;                                    
                                        uart_caps = false;
                                        uart_caps_word_flash_last = now;
                                    }
                                }
                            } else if (code == SHIFT_RIGHT_CODE_D) {
                                if (uart_lshift) {
                                    if (uart_caps_word) {
                                        // cancel caps word
                                        uart_caps_word = false;
                                        uart_caps = false;
                                        uart_caps_led_on = false;
                                        led_off(LED_CAPS);
                                    } else {
                                        // enable caps word
                                        if (uart_caps_led_on) { // Immediate flash start!
                                            led_off(LED_CAPS);  // start off if already on
                                            uart_caps_led_on = false;
                                        } else {
                                            led_on(LED_CAPS);   // and vice versa
                                            uart_caps_led_on = true;
                                        }

                                        uart_caps_word = true;                                    
                                        uart_caps = false;
                                        led_on(LED_CAPS);
                                        uart_caps_word_flash_last = now;
                                    }
                                }
                            }
                        }
                    } else {
                        // key already down - are we repeating?
                        if (repeat_delay > 0) {
                            if (keys_r[row][col]) {
                                // Already repeating - time for another break?
                                if (now - keys_t[row][col] > repeat_rate_limit) {
                                    // yes - send it
                                    uart_repeat_keypress(row, col);
                                    keys_t[row][col] = now;
                                }
                            } else {
                                // not repeating - time to start?
                                if (now - keys_t[row][col] > repeat_delay) {
                                    // yes - start repeating
                                    uart_repeat_keypress(row, col);
                                    keys_t[row][col] = now;
                                    keys_r[row][col] = true;
                                }
                            }
                        }
                    }
                } else {
                    if (keys[row][col]) {
                        keys[row][col] = false;
                        keys_r[row][col] = false;
                        keys_t[row][col] = now;

                        uint8_t code = keyup(row, col);

                        if (!uart_process_special(code)) {
                            uint8_t ascii = uart_keybreak_code(code);

                            uart_send_keypress(code);

                            // Cancel caps word?
                            if (uart_caps_word && is_ascii_word_terminator(ascii)) {
                                uart_caps_word = false;
                                uart_caps_led_on = false;
                                led_off(LED_CAPS);
                            }
                        }
                    }
                }
            }
        }

        digitalWrite(row_pin, HIGH);
        pinMode(row_pin, INPUT);

        // Check caps word flash
        if (uart_caps_word) {
            if (now - uart_caps_word_flash_last > CAPS_WORD_FLASH_D) {
                // Time to switch
                if (uart_caps_led_on) {
                    led_off(LED_CAPS);
                    uart_caps_led_on = false;
                } else {
                    led_on(LED_CAPS);
                    uart_caps_led_on = true;
                }

                uart_caps_word_flash_last = now;
            }
        }

        // Does SPI need anything? - check after each row to make overrun less likely
        service_spi();
    }
}

static inline __attribute__((always_inline)) void scancode_loop(void) {
    unsigned long now = millis();

    for (int row = 0; row < ROW_COUNT; row++) {
        uint8_t row_pin = pgm_read_byte_near(row_pins + row);
        pinMode(row_pin, OUTPUT);
        digitalWrite(row_pin, LOW);

#       if ROW_SETTLE_DELAY
        delayMicroseconds(ROW_SETTLE_DELAY);
#       endif

        for (int col = 0; col < COL_COUNT; col++) {
            // Handle any passthru...
            if (uart_passthru) {
                while (PT_UART.available() > 0) {
                    M_UART.write(PT_UART.read());
                }
                while (M_UART.available() > 0) {
                    PT_UART.write(M_UART.read());
                }
            }

            uint8_t col_pin = pgm_read_byte_near(col_pins + col);

            if (now - keys_t[row][col] > DEBOUNCE_MILLIS) {
                if (!digitalRead(col_pin)) {
                    if (!keys[row][col]) {
                        keys[row][col] = true;
                        keys_t[row][col] = now;
                        M_UART.write(keydown(row, col));
                    } else {
                        // key already down - are we repeating?
                        if (key_is_repeatable(keydown(row, col)) && repeat_delay > 0) {
                            if (keys_r[row][col]) {
                                // Already repeating - time for another make?
                                if (now - keys_t[row][col] > repeat_rate_limit) {
                                    // yes - send it
                                    M_UART.write(keydown(row, col));
                                    keys_t[row][col] = now;
                                }
                            } else {
                                // not repeating - time to start?
                                if (now - keys_t[row][col] > repeat_delay) {
                                    // yes - start repeating
                                    M_UART.write(keydown(row, col));
                                    keys_t[row][col] = now;
                                    keys_r[row][col] = true;
                                }
                            }
                        }

                    }
                } else {
                    if (keys[row][col]) {
                        keys[row][col] = false;
                        keys_r[row][col] = false;
                        keys_t[row][col] = now;
                        M_UART.write(keyup(row, col));
                    }
                }
            }
        }

        digitalWrite(row_pin, HIGH);
        pinMode(row_pin, INPUT);

        // Does SPI need anything? - check after each row to make overrun less likely
        service_spi();
    }
}

void setup(void) {
    // First, check global disable - if disabled, we don't touch any other pins...
    pinMode(G_DISABLE_JP_I, INPUT_PULLUP);
    global_disable = digitalRead(G_DISABLE_JP_I) == LOW;

    if (!global_disable) {
        // LED port output, all off
        POW_DDR = 0xff;
        POW_OPORT = 0xff;
        LED_DDR = 0xff;
        LED_OPORT = 0xff;

        // Turn on power LED (green)
        //pow_on(POW_RED);
        analogWrite(PIN_PE3, 0);
        analogWrite(PIN_PE4, 255);
        analogWrite(PIN_PE5, 255);

        // And disk LED while we do init...
        led_on(LED_DISK);

        // Figure out which mode we're in
        pinMode(UART_MODE_JP_I, INPUT_PULLUP);
        uart_mode = digitalRead(UART_MODE_JP_I) == HIGH;

        // Figure out which speed we want, and should we enable pass-thru
        pinMode(UART_SPEED_JP_I, INPUT_PULLUP);
        pinMode(PASS_THRU_JP_I, INPUT_PULLUP);
        if (digitalRead(UART_SPEED_JP_I) == LOW) {
            M_UART.begin(9600);

            if (digitalRead(PASS_THRU_JP_I) == LOW) {
                uart_passthru = true;
                PT_UART.begin(9600);
            }
        } else {
            M_UART.begin(115200);

            if (digitalRead(PASS_THRU_JP_I) == LOW) {
                uart_passthru = true;
                PT_UART.begin(115200);
            }
        }

#ifdef REVISION_2
        // Setup as SPI slave
        M_UART.print("Setting up SPI...\n");
        pinMode(MISO, OUTPUT);
        SPCR |= _BV(SPE);
        SPCR |= _BV(SPIE);
#endif

        // Do we want PS/2 or I2C?
        pinMode(I2C_JP_I, INPUT_PULLUP);
        if (digitalRead(I2C_JP_I) == LOW) {
            // I2C...
            i2c_mode = true;

            // TODO not implemented...
        } else {
            // Mouse...
            i2c_mode = false;
        }

        // Setup key matrix array
        for (int r = 0; r < ROW_COUNT; r++) {
            for (int c = 0; c < COL_COUNT; c++) {
                keys[r][c] = 0;
                keys_t[r][c] = 0;
            }
        }

        // Set up row pins
        for (int i = 0; i < ROW_COUNT; i++) {
            uint8_t row_pin = pgm_read_byte_near(row_pins + i);
            pinMode(row_pin, OUTPUT);
            digitalWrite(row_pin, HIGH);
        }

        // Set up column pins
        for (int i = 0; i < COL_COUNT; i++) {
            pinMode(pgm_read_byte_near(col_pins + i), INPUT_PULLUP);
        }

        // default repeat
        repeat_delay = DEFAULT_RPT_DELAY;
        repeat_rate_limit = DEFAULT_RATE_LIMIT;

        // Init done...
        led_off(LED_DISK);
    }

    // Restart after 1S unresponsive...
    wdt_enable(WDTO_1S);
}

void loop(void) {
    if (!global_disable) {
        if (uart_mode) {
            uart_loop();
        } else {
            scancode_loop();
        }

        // Any commands waiting?
        if (!uart_passthru) {
            while (M_UART.available()) {
                process_command(M_UART.read());
            }
        }

        // Anything happening with the mouse?
        if (!uart_mode && enable_mouse_reports) {
            service_mouse();
        }
    }

    wdt_reset();
}
