rosco-m68k/rosco_keyboard/code/mcu/src/tables.hpp

#ifndef __ROSCO_KEYBOARD_TABLES_H
#define __ROSCO_KEYBOARD_TABLES_H

#include <avr/pgmspace.h>

const PROGMEM uint8_t uart_keys_nocaps_unshift[] = {
    0,   0,   0,   0,   0,   0,   0,   0,   0,   0,   0,   0,   0,   0,   0,   0,
    0,   27,  '1', '2', '3', '4', '5', '6', '7', '8', '9', '0', '-', '=', 8,   0,
    0,   '\t','q', 'w', 'e', 'r', 't', 'y', 'u', 'i', 'o', 'p', '[', ']', '\\',0,
    0,   0,   'a', 's', 'd', 'f', 'g', 'h', 'j', 'k', 'l', ';', '\'',0,   '\r',0,
    0,   0,   '`', 'z', 'x', 'c', 'v', 'b', 'n', 'm', ',', '.', '/', 0,   0,   0,
    0,   0,   0,   0,   0,   0,   0,   ' ', 0,   0,   0,   0,   0,   0,   0,   0,
    0,   0,   0,   0,   0,   0,   0,   0,   0,   0,   0,   0,   0,   0,   0,   0,
    0,   0,   0,   0,   0,   0,   0,   0,   0,   0,   0,   0,   0,   0,   0,   0,
    0,   0,   0,   0,   0,   0,   0,   0,   0,   0,   0,   0,   0,   0,   0,   0,
    0,   0,   0,   0,   0,   0,   0,   0,   0,   0,   0,   0,   0,   0,   0,   0,
    0,   0,   0,   0,   0,   0,   0,   0,   0,   0,   0,   0,   0,   0,   0,   0,
    0,   0,   0,   0,   0,   0,   0,   0,   0,   0,   0,   0,   0,   0,   0,   0,
    0,   0,   0,   0,   0,   0,   0,   0,   0,   0,   0,   0,   0,   0,   0,   0,
    0,   0,   0,   0,   0,   0,   0,   0,   0,   0,   0,   0,   0,   0,   0,   0,
    0,   0,   0,   0,   0,   0,   0,   0,   0,   0,   0,   0,   0,   0,   0,   0,
    0,   0,   0,   0,   0,   0,   0,   0,   0,   0,   0,   0,   0,   0,   0,   0,
};

const PROGMEM uint8_t uart_keys_nocaps_shift[] = {
    0,   0,   0,   0,   0,   0,   0,   0,   0,   0,   0,   0,   0,   0,   0,   0,
    0,   27,  '!', '@', '#', '$', '%', '^', '&', '*', '(', ')', '_', '+', 8,   0,
    0,   '\t','Q', 'W', 'E', 'R', 'T', 'Y', 'U', 'I', 'O', 'P', '{', '}', '|', 0,
    0,   0,   'A', 'S', 'D', 'F', 'G', 'H', 'J', 'K', 'L', ':', '"', 0,   '\r',0,
    0,   0,   '~', 'Z', 'X', 'C', 'V', 'B', 'N', 'M', '<', '>', '?', 0,   0,   0,
    0,   0,   0,   0,   0,   0,   0,   ' ', 0,   0,   0,   0,   0,   0,   0,   0,
    0,   0,   0,   0,   0,   0,   0,   0,   0,   0,   0,   0,   0,   0,   0,   0,
    0,   0,   0,   0,   0,   0,   0,   0,   0,   0,   0,   0,   0,   0,   0,   0,
    0,   0,   0,   0,   0,   0,   0,   0,   0,   0,   0,   0,   0,   0,   0,   0,
    0,   0,   0,   0,   0,   0,   0,   0,   0,   0,   0,   0,   0,   0,   0,   0,
    0,   0,   0,   0,   0,   0,   0,   0,   0,   0,   0,   0,   0,   0,   0,   0,
    0,   0,   0,   0,   0,   0,   0,   0,   0,   0,   0,   0,   0,   0,   0,   0,
    0,   0,   0,   0,   0,   0,   0,   0,   0,   0,   0,   0,   0,   0,   0,   0,
    0,   0,   0,   0,   0,   0,   0,   0,   0,   0,   0,   0,   0,   0,   0,   0,
    0,   0,   0,   0,   0,   0,   0,   0,   0,   0,   0,   0,   0,   0,   0,   0,
    0,   0,   0,   0,   0,   0,   0,   0,   0,   0,   0,   0,   0,   0,   0,   0,
};

const PROGMEM uint8_t uart_keys_caps_unshift[] = {
    0,   0,   0,   0,   0,   0,   0,   0,   0,   0,   0,   0,   0,   0,   0,   0,
    0,   27,  '1', '2', '3', '4', '5', '6', '7', '8', '9', '0', '-', '=', 8,   0,
    0,   '\t','Q', 'W', 'E', 'R', 'T', 'Y', 'U', 'I', 'O', 'P', '[', ']', '\\',0,
    0,   0,   'A', 'S', 'D', 'F', 'G', 'H', 'J', 'K', 'L', ';', '\'',0,   '\r',0,
    0,   0,   '`', 'Z', 'X', 'C', 'V', 'B', 'N', 'M', ',', '.', '/', 0,   0,   0,
    0,   0,   0,   0,   0,   0,   0,   ' ', 0,   0,   0,   0,   0,   0,   0,   0,
    0,   0,   0,   0,   0,   0,   0,   0,   0,   0,   0,   0,   0,   0,   0,   0,
    0,   0,   0,   0,   0,   0,   0,   0,   0,   0,   0,   0,   0,   0,   0,   0,
    0,   0,   0,   0,   0,   0,   0,   0,   0,   0,   0,   0,   0,   0,   0,   0,
    0,   0,   0,   0,   0,   0,   0,   0,   0,   0,   0,   0,   0,   0,   0,   0,
    0,   0,   0,   0,   0,   0,   0,   0,   0,   0,   0,   0,   0,   0,   0,   0,
    0,   0,   0,   0,   0,   0,   0,   0,   0,   0,   0,   0,   0,   0,   0,   0,
    0,   0,   0,   0,   0,   0,   0,   0,   0,   0,   0,   0,   0,   0,   0,   0,
    0,   0,   0,   0,   0,   0,   0,   0,   0,   0,   0,   0,   0,   0,   0,   0,
    0,   0,   0,   0,   0,   0,   0,   0,   0,   0,   0,   0,   0,   0,   0,   0,
    0,   0,   0,   0,   0,   0,   0,   0,   0,   0,   0,   0,   0,   0,   0,   0,
};

const PROGMEM uint8_t uart_keys_caps_shift[] = {
    0,   0,   0,   0,   0,   0,   0,   0,   0,   0,   0,   0,   0,   0,   0,   0,
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
    0,   0,    0,    0,    0,    0,    0,    0,    0,    0,    0,    0,    0,    0,    0,   0,
    0,   0,    0,    0,    0,    0,    0,    0,    0,    0,    0,    0,    0,    0,    0,   0,
};

#endif//__ROSCO_KEYBOARD_TABLES_H
