rosco-m68k/rosco_keyboard/(commit log)

2023-12-09 first cut, not work
    [BOM-rosco_m68k_keyboard-2.csv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]
2023-12-16 Tidy up PCB
    [rosco_m68k_keyboard-2.kicad_sch]
2023-12-16 New layout
    [BOM-rosco_m68k_keyboard-2.csv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]
2023-12-16 Test blend / STL for recessed logo
    [recess-logo-test.blend, recess-logo-test.stl]
2023-12-16 Import MCU code from proto project
    commit 596c496f295699712820366e45f4d8e0e89bdddd (HEAD -> main)
    Author: Ross Bamford <roscopeco@gmail.com>
    Date: Tue Dec 12 22:16:39 2023 +0000
    Repeat
    commit 8b7e46a16dc4fbad3c6976d09e9c6568c6a10680
    Author: Ross Bamford <roscopeco@gmail.com>
    Date: Tue Dec 12 21:21:14 2023 +0000
    consts to PROGMEM
    commit 3a85b2703ee7bae7a32df140112e9c68fb799545
    Author: Ross Bamford <roscopeco@gmail.com>
    Date: Tue Dec 12 21:10:31 2023 +0000
    Command mode, better debounce with real switches
    commit a3f0fdc9620904b40ad4ceb628969e5517aef544
    Author: Ross Bamford <roscopeco@gmail.com>
    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
2023-12-16 Update r1
    [BOM-rosco_m68k_keyboard-2.csv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]
2023-12-16 Add key BOM
2023-12-16 Graphics tidy up
    [rosco_m68k_keyboard-2-CuBottom.gbr, rosco_m68k_keyboard-2-CuTop.gbr, rosco_m68k_keyboard-2-EdgeCuts.gbr, rosco_m68k_keyboard-2-MaskBottom.gbr, rosco_m68k_keyboard-2-MaskTop.gbr, rosco_m68k_keyboard-2-NPTH.drl, rosco_m68k_keyboard-2-PTH.drl, rosco_m68k_keyboard-2-PasteBottom.gbr]
2023-12-16 More silk updates
    [rosco_m68k_keyboard-2-CuBottom.gbr, rosco_m68k_keyboard-2-CuTop.gbr, rosco_m68k_keyboard-2-EdgeCuts.gbr, rosco_m68k_keyboard-2-MaskBottom.gbr, rosco_m68k_keyboard-2-MaskTop.gbr, rosco_m68k_keyboard-2-NPTH.drl, rosco_m68k_keyboard-2-PTH.drl, rosco_m68k_keyboard-2-PasteBottom.gbr]
2023-12-17 ASCII mode fixes, signature changed
    [main.cpp]
2023-12-17 Update sample code
2023-12-17 Feature/standard keys (#1)
    * DFM layout, stabs, rerouted
    * Overhaul layout
    * Manufacturing files
    [BOM-rosco_m68k_keyboard-2.csv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]
2023-12-27 r1 MCU code changes (#2)
    * Change MCU pin layout for r1 board
    * Key matrix update for r1
2023-12-27 Add new plate concept and design
    [rosco-keyboard-plate-new.dxf]
2024-01-11 UART mode by default
2024-01-11 Add first proto step files
    [rosco_m68k_keyboard_v17_base.step, rosco_m68k_keyboard_v17_plate.step, rosco_m68k_keyboard_v17_top.step]
2024-01-12 Implement SPI
2024-01-12 Fix Power LED SNAFU
    [BOM-rosco_m68k_keyboard-2.csv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]
2024-01-13 Sort out fuses and create programming scripts
2024-01-13 Revision two
    [BOM-rosco_m68k_keyboard-2.csv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]
2024-01-14 Fix SPI for slave
    [rosco_m68k_keyboard-2-CuBottom.gbr, rosco_m68k_keyboard-2-CuTop.gbr, rosco_m68k_keyboard-2-EdgeCuts.gbr, rosco_m68k_keyboard-2-MaskBottom.gbr, rosco_m68k_keyboard-2-MaskTop.gbr, rosco_m68k_keyboard-2-NPTH.drl, rosco_m68k_keyboard-2-PTH.drl, rosco_m68k_keyboard-2-PasteBottom.gbr]
2024-01-17 PT UART pinout fix, tidy up
    [rosco_m68k_keyboard-2-CuBottom.gbr, rosco_m68k_keyboard-2-CuTop.gbr, rosco_m68k_keyboard-2-EdgeCuts.gbr, rosco_m68k_keyboard-2-MaskBottom.gbr, rosco_m68k_keyboard-2-MaskTop.gbr, rosco_m68k_keyboard-2-NPTH.drl, rosco_m68k_keyboard-2-PTH.drl, rosco_m68k_keyboard-2-PasteBottom.gbr]
2024-01-23 PS2 connector
    [rosco_m68k_keyboard-2-CuBottom.gbr, rosco_m68k_keyboard-2-CuTop.gbr, rosco_m68k_keyboard-2-EdgeCuts.gbr, rosco_m68k_keyboard-2-MaskBottom.gbr, rosco_m68k_keyboard-2-MaskTop.gbr, rosco_m68k_keyboard-2-NPTH.drl, rosco_m68k_keyboard-2-PTH.drl, rosco_m68k_keyboard-2-PasteBottom.gbr]
2024-01-24 USB-C, Silk readability
    [CPL-rosco_m68k_keyboard-2.csv, rosco_m68k_keyboard-2-CuBottom.gbr, rosco_m68k_keyboard-2-CuTop.gbr, rosco_m68k_keyboard-2-EdgeCuts.gbr, rosco_m68k_keyboard-2-MaskBottom.gbr, rosco_m68k_keyboard-2-MaskTop.gbr, rosco_m68k_keyboard-2-NPTH.drl, rosco_m68k_keyboard-2-PTH.drl]
2024-01-24 Add LCSC for USB conn
    [rosco_m68k_keyboard-2.kicad_sch]
2024-01-25 Fix power LED issue
    [main.cpp]
2024-01-27 PS/2 by default, I2C requires jumper
2024-01-28 Move opt power connection for case
    [rosco_m68k_keyboard-2-CuBottom.gbr, rosco_m68k_keyboard-2-CuTop.gbr, rosco_m68k_keyboard-2-EdgeCuts.gbr, rosco_m68k_keyboard-2-MaskBottom.gbr, rosco_m68k_keyboard-2-MaskTop.gbr, rosco_m68k_keyboard-2-NPTH.drl, rosco_m68k_keyboard-2-PTH.drl, rosco_m68k_keyboard-2-PasteBottom.gbr]
2024-01-28 Regenerate production files
    [rosco_m68k_keyboard-2-CuBottom.gbr, rosco_m68k_keyboard-2-CuTop.gbr, rosco_m68k_keyboard-2-EdgeCuts.gbr, rosco_m68k_keyboard-2-MaskBottom.gbr, rosco_m68k_keyboard-2-MaskTop.gbr, rosco_m68k_keyboard-2-NPTH.drl, rosco_m68k_keyboard-2-PTH.drl, rosco_m68k_keyboard-2-PasteBottom.gbr]
2024-01-30 Fix ENTER not breaking caps word
    [main.cpp]
2024-02-06 r2 sent for manufacturing
    [BOM-rosco_m68k_keyboard-2.csv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]
2024-02-10 Fix pullups on I2C jumper
    [main.cpp, pins.hpp]
2024-02-13 Initial r2 prob fixes
    [BOM-rosco_m68k_keyboard-2.csv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]
2024-02-15 Add standoffs
    [Middle Standoff.step, Side Standoff.step]
2024-02-15 Add STL
    [keyboard-standoffs v8.stl]
2024-02-15 Fix USB hookup errors
    [BOM-rosco_m68k_keyboard-2.csv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]
2024-02-17 Add new stand-off
    [Side Standoff.step, keyboard-standoff v9.stl]
2024-02-29 Update v24 steps for manufacturing
    [rosco_m68k_keyboard_v17_base.step, rosco_m68k_keyboard_v17_plate.step, rosco_m68k_keyboard_v17_top.step, rosco_m68k_keyboard_v24_Base.step, rosco_m68k_keyboard_v24_Top.step]
2024-03-07 Revision 2 manufacture
    [rosco_m68k_keyboard-2-CuBottom.gbr, rosco_m68k_keyboard-2-CuTop.gbr, rosco_m68k_keyboard-2-EdgeCuts.gbr, rosco_m68k_keyboard-2-MaskBottom.gbr, rosco_m68k_keyboard-2-MaskTop.gbr, rosco_m68k_keyboard-2-NPTH.drl, rosco_m68k_keyboard-2-PTH.drl, rosco_m68k_keyboard-2-PasteBottom.gbr]
2024-03-07 Add ancilliary files
    [keys-illustration.stl, rosco_m68k-r2020.STEP]
2024-09-14 QR Code
    [rosco_m68k_keyboard-2-CuBottom.gbr, rosco_m68k_keyboard-2-CuTop.gbr, rosco_m68k_keyboard-2-EdgeCuts.gbr, rosco_m68k_keyboard-2-MaskBottom.gbr, rosco_m68k_keyboard-2-MaskTop.gbr, rosco_m68k_keyboard-2-NPTH.drl, rosco_m68k_keyboard-2-PTH.drl, rosco_m68k_keyboard-2-PasteBottom.gbr]
2025-04-23 Add everything for open sourcing
    [keyboard-2-plate LHS v1.step, keyboard-2-plate RHS v2.step, keyboard-2-plate v10 - Support LHS.step, keyboard-2-plate v10 - Support RHS.step, keyboard-2-plate v11 - Base LHS.step, keyboard-2-plate v11 - Base Middle.step, keyboard-2-plate v11 - Base RHS.step, keyboard-2-plate v13 - Base LHS.step]
